jamespilgrim/Pi-Camera-Light-Filter-Holder/Filter Holder on Camera.jpg

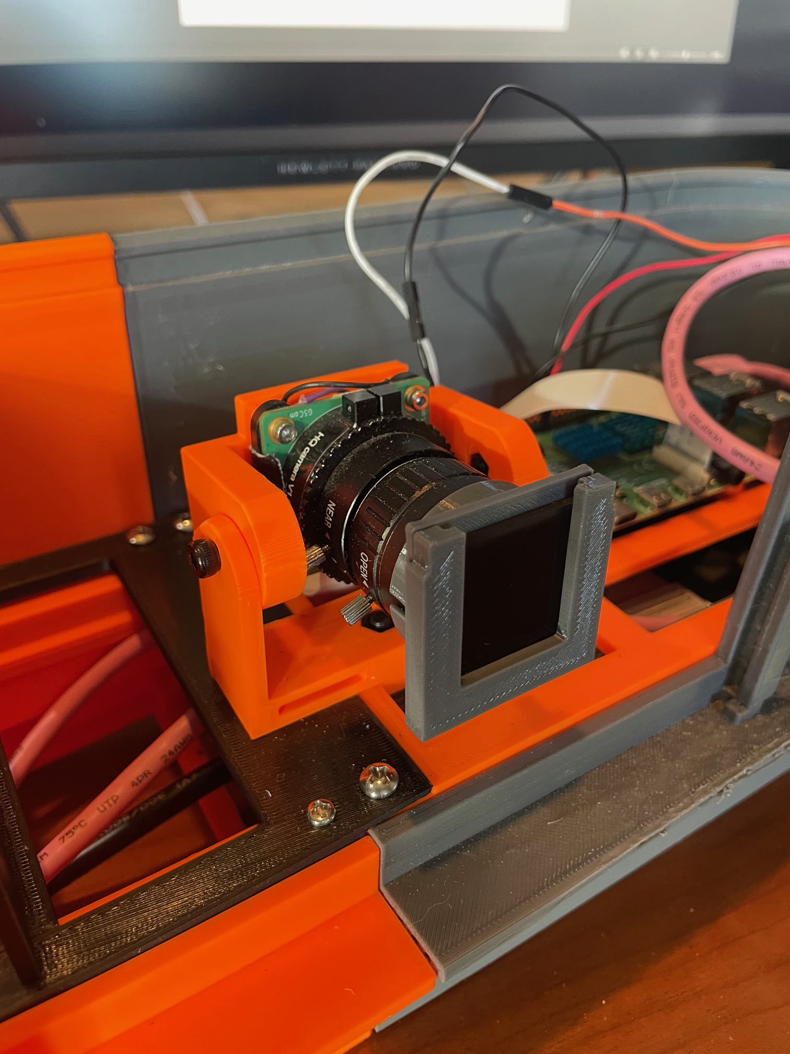
Filter Holder on Camera.jpg
