jamespilgrim/Pi-Camera-Light-Filter-Holder/Filter Holder - 3D Model.png

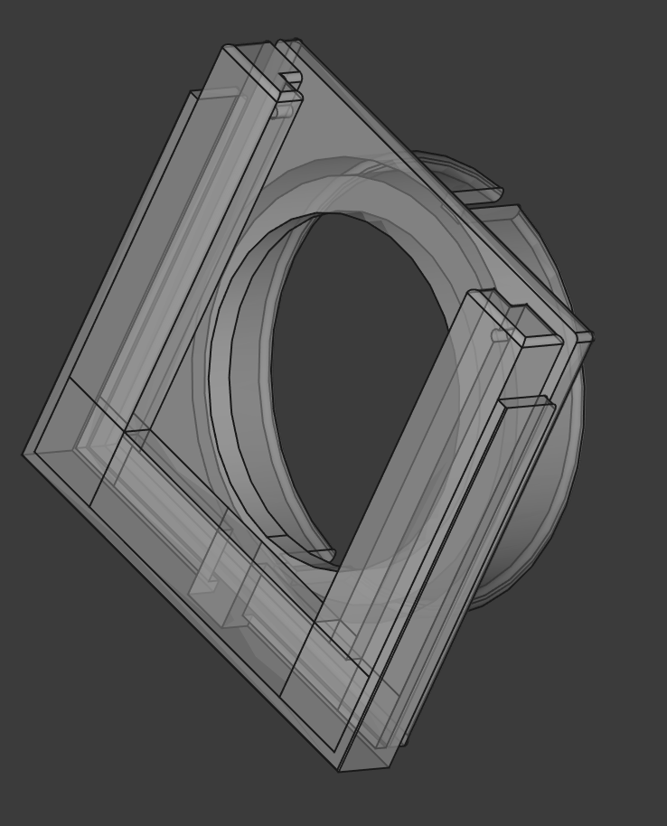
Filter Holder - 3D Model.png
