jamespilgrim/Pi-Camera-Light-Filter-Holder/Filter Holder - Annotated 3D Model.png

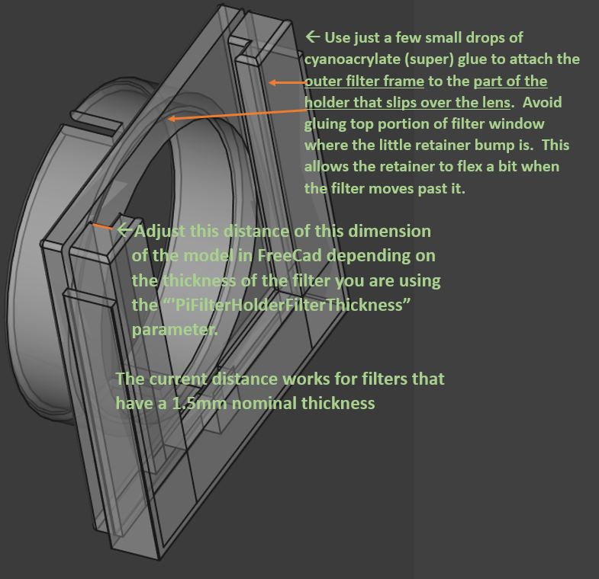
Filter Holder - Annotated 3D Model.png
