jamespilgrim/Pi-Camera-Light-Filter-Holder/Filter Holder - Prusa Slicer Output.png

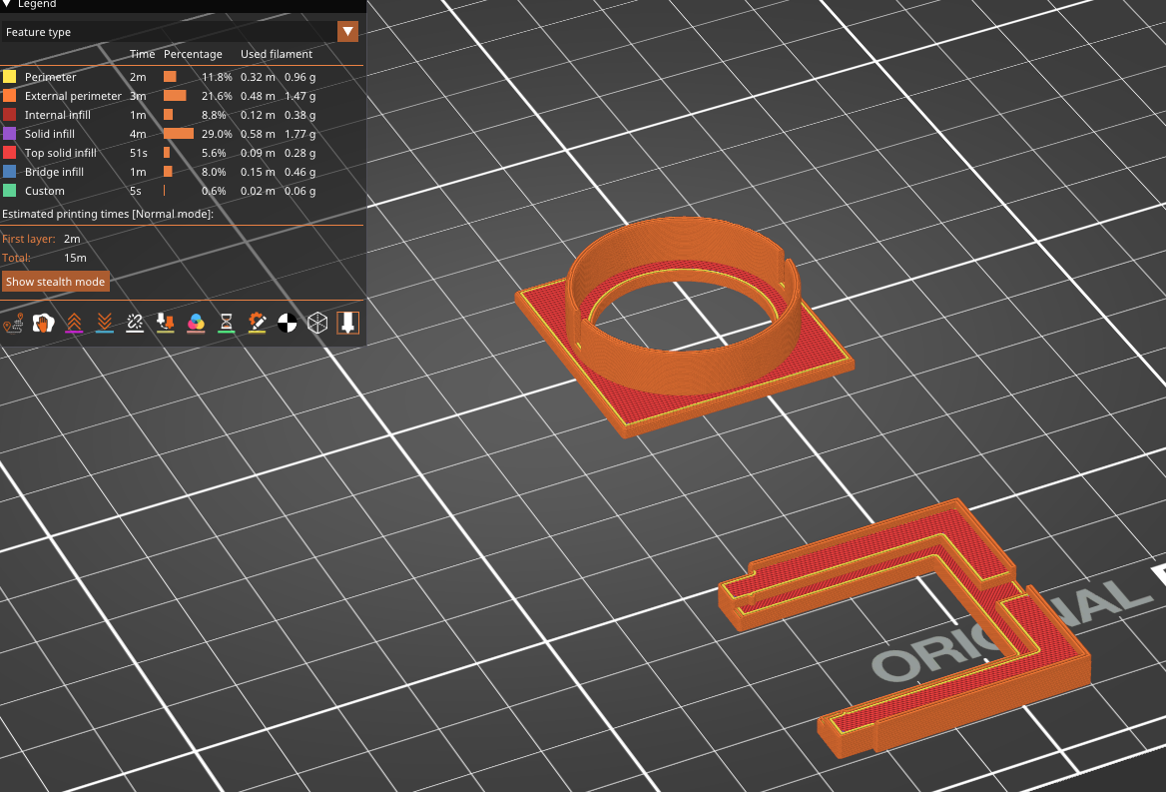
Filter Holder - Prusa Slicer Output.png
