jamespilgrim/Pi-Camera-Light-Filter-Holder/Pi Cam Filter Holder.FCStd

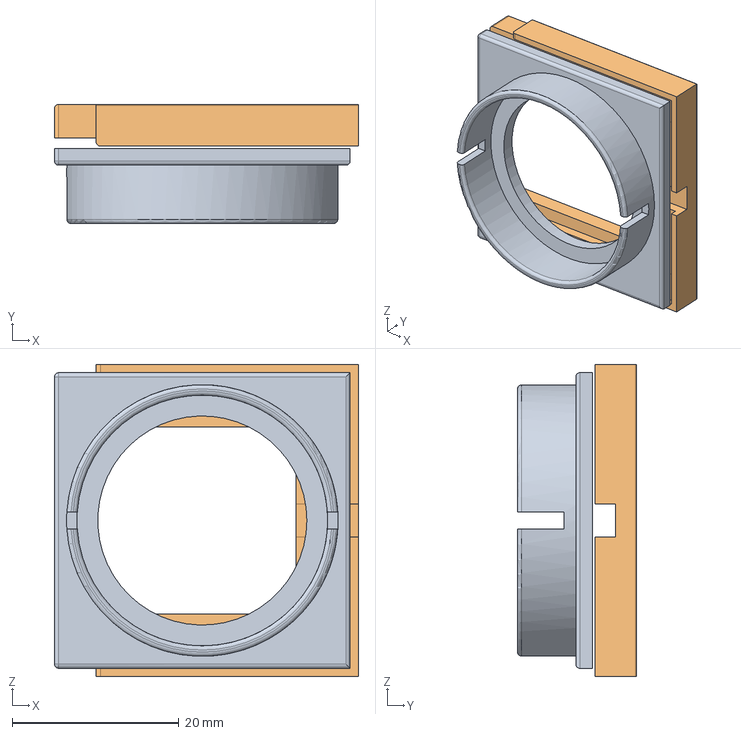
[picture p5: CAD file, 2024-11-25]
Pi Cam Filter Holder.FCStd
36.5 x 14.3 x 37.5 mm
Filter Holder Body
Holder Wings Body
