jamespilgrim/Pi-Camera-Light-Filter-Holder/(list of files, cad)

Other CAD files:
Master Document.FCStd
Pi Cam Filter Holder.3mf
Pi Cam Filter Holder.stl
